Wetmelon/Salus/Hardware/Salus.pdf

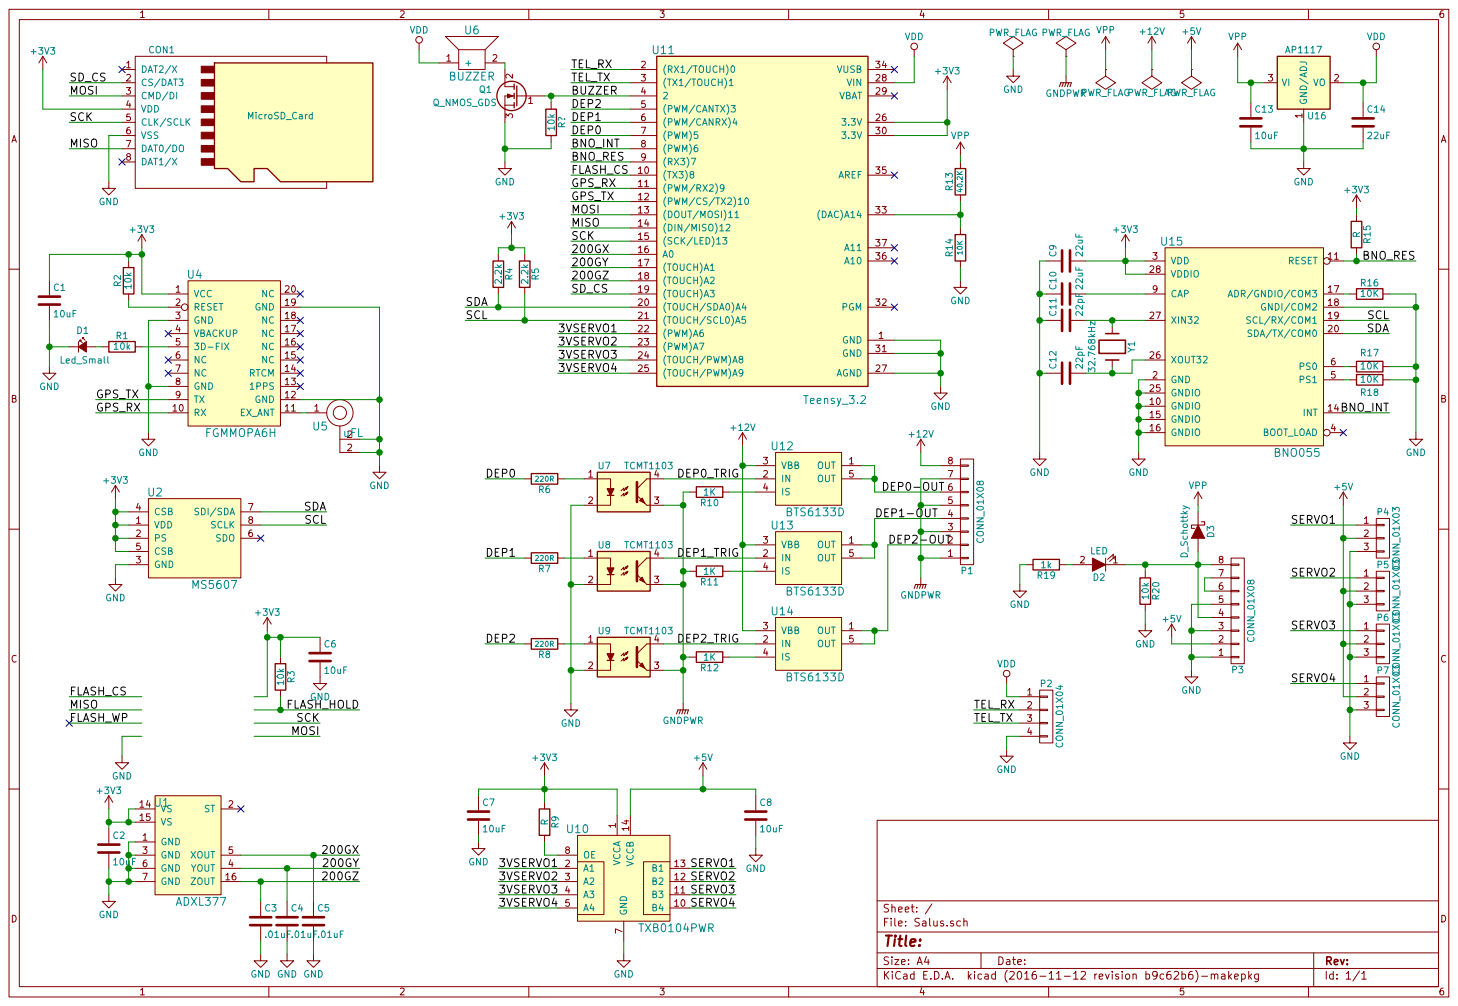
[picture p1: page 1]

Id: 1/1 Title: File: Salus.sch Sheet: /
