Wetmelon/Salus/Hardware/Salus_Board.pdf

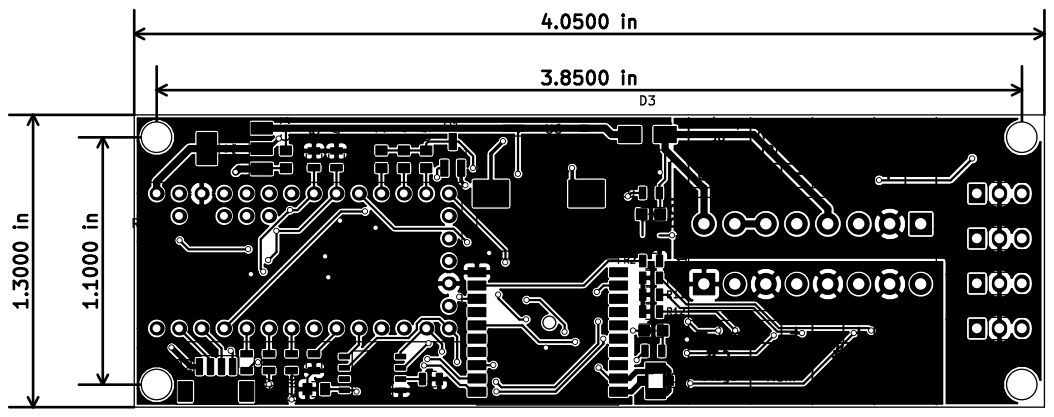
[picture p2: page 1]
