Wetmelon/Salus/Hardware/Salus.kicad_pcb

## KiCad design Hardware/Salus.kicad_pcb (2017-03-23)

Schematic: Salus.sch

Parts:
C1, C2, C6, C7, C8, C13: 10uF; C_0805
C3, C4, C5: .01uF; C_0805
C9, C10, C14: 22uF; C_0805
C11, C12: 22pF; C_0805
CON1: MicroSD_Card; MicroSD_TF001B
D1: Led_Small; LED-0805
D2: LED; LED-0805
D3: D_Schottky; SMA_Standard
P1, P3: CONN_01X08; TerminalBlock_Pheonix_PT-3.5mm_8pol
P2: CONN_01X04; DF13-4
P4, P5, P6, P7: CONN_01X03; Pin_Header_Straight_1x03
Q1: Q_NMOS_GDS; SOT-23_Handsoldering
R1, R2, R3, R20: 10k; R_0805
R4, R5: 2.2k; R_0805
R6, R7, R8: 220R; R_0805
R9, R15: R; R_0805
R10, R11, R12: 1K; R_0805
R13: 40.2K; R_0805
R14, R16, R17, R18: 10K; R_0805
R19: 1k; R_0805
U1: ADXL377; QFP_16
U2: MS5607
U3: S25FL127SAMBFI101; SOIC-8-N
U4: FGMMOPA6H; FGPMMOPA6H
U5: uFL; U.FL-CON
U6: BUZZER; CT-1205C-SMT
U7, U8, U9: TCMT1103; SOIC-4
U10: TXB0104PWR; TSSOP-14
U11: Teensy_3.2; Teensy_3.2+4
U12, U13, U14: BTS6133D; TO-252-5
U15: BNO055; LGA28_5832
U16: AP1117; SOT-223
Y1: 32.768kHz; SOJ-4

Connections:
+3V3: C1.1, C2.1, C6.1, C7.1, C9.2, CON1.4 (VDD), R2.2, R3.1, R4.1, R5.1, R9.1, R15.1, U1.14 (VS), U1.15 (VS), U2.1 (VDD), U2.2 (PS), U2.4 (CSB), U2.5 (CSB), U3.5, U4.1 (VCC), U10.1 (VCCA), U11.26 (3.3V), U11.30 (3.3V), U15.3 (VDD), U15.28 (VDDIO)
+5V: C8.1, P3.2, P4.2, P5.2, P6.2, P7.2, U10.14 (VCCB)
+12V: P1.8, U12.3 (VBB), U13.3 (VBB), U14.3 (VBB)
/3VSERVO1: U10.2 (A1), U11.22 ((PWM)A6)
/3VSERVO2: U10.3 (A2), U11.23 ((PWM)A7)
/3VSERVO3: U10.4 (A3), U11.24 ((TOUCH/PWM)A8)
/3VSERVO4: U10.5 (A4), U11.25 ((TOUCH/PWM)A9)
/200GX: C5.1, U1.5 (XOUT), U11.16 (A0)
/200GY: C4.1, U1.4 (YOUT), U11.17 ((TOUCH)A1)
/200GZ: C3.1, U1.16 (ZOUT), U11.18 ((TOUCH)A2)
/BNO_INT: U11.8 ((PWM)6), U15.14 (INT)
/BNO_RES: R15.2, U11.9 ((RX3)7), U15.11 (RESET)
/BUZZER: Q1.1 (G), U11.4 (2)
/DEP0: R6.2, U11.7 ((PWM)5)
/DEP0-OUT: P1.6, U12.1 (OUT), U12.5 (OUT)
/DEP0_TRIG: U7.4, U12.2 (IN)
/DEP1: R7.2, U11.6 ((PWM/CANRX)4)
/DEP1-OUT: P1.4, U13.1 (OUT), U13.5 (OUT)
/DEP1_TRIG: U8.4, U13.2 (IN)
/DEP2: R8.2, U11.5 ((PWM/CANTX)3)
/DEP2-OUT: P1.2, U14.1 (OUT), U14.5 (OUT)
/DEP2_TRIG: U9.4, U14.2 (IN)
/FLASH_CS: U3.1, U11.10 ((TX3)8)
/FLASH_HOLD: R3.2, U3.6
/FLASH_WP: U3.3
/GPS_RX: U4.10 (RX), U11.11 ((PWM/RX2)9)
/GPS_TX: U4.9 (TX), U11.12 ((PWM/CS/TX2)10)
/MISO: CON1.7 (DAT0/DO), U3.2, U11.14 ((DIN/MISO)12)
/MOSI: CON1.3 (CMD/DI), U3.8, U11.13 ((DOUT/MOSI)11)
/SCK: CON1.5 (CLK/SCLK), U3.7, U11.15 ((SCK/LED)13)
/SCL: R5.2, U2.8 (SCLK), U11.21 ((TOUCH/SCL0)A5), U15.19 (SCL/RX/COM1)
/SDA: R4.2, U2.7 (SDI/SDA), U11.20 ((TOUCH/SDA0)A4), U15.20 (SDA/TX/COM0)
/SD_CS: CON1.2 (CS/DAT3), U11.19 ((TOUCH)A3)
/SERVO1: P4.1, U10.13 (B1)
/SERVO2: P5.1, U10.12 (B2)
/SERVO3: P6.1, U10.11 (B3)
/SERVO4: P7.1, U10.10 (B4)
/TEL_RX: P2.2, U11.2 ((RX1/TOUCH)0)
/TEL_TX: P2.3, U11.3 ((TX1/TOUCH)1)
GND: C1.2, C2.2, C3.2, C4.2, C5.2, C6.2, C7.2, C8.2, C9.1, C10.1, C11.1, C12.1, C13.2, C14.2, CON1.6 (VSS), D1.1 (K), P2.4, P3.1, P3.3, P3.5, P4.3, P5.3, P6.3, P7.3, Q1.3 (S), R14.1, R16.2, R17.2, R18.2, R19.2, R20.2, U1.1 (GND), U1.3 (GND), U1.6 (GND), U1.7 (GND), U2.3 (GND), U3.4, U4.3 (GND), U4.8 (GND), U4.12 (GND), U4.19 (GND), U5.2, U7.2, U8.2, U9.2, U10.7 (GND), U11.1 (GND), U11.27 (AGND), U11.31 (GND), U15.2 (GND), U15.10 (GNDIO), U15.15 (GNDIO), U15.16 (GNDIO), U15.18 (GNDI/COM2), U15.25 (GNDIO), U16.1 (GND/ADJ)
GNDPWR: P1.1, P1.3, P1.5, P1.7, R10.2, R11.2, R12.2, U7.3, U8.3, U9.3
unnamed: C10.2, U15.9 (CAP)
unnamed: C11.2, U15.27 (XIN32), Y1.1
unnamed: C12.2, U15.26 (XOUT32), Y1.4 (2)
unnamed: D1.2 (A), R1.1
unnamed: D2.1 (K), D3.2 (A), P3.4, P3.8, R20.1
unnamed: D2.2 (A), R19.1
unnamed: P3.6, P3.7
unnamed: Q1.2 (D), U6.2
unnamed: R1.2, U4.5 (3D-FIX)
unnamed: R2.1, U4.2 (RESET)
unnamed: R6.1, U7.1
unnamed: R7.1, U8.1
unnamed: R8.1, U9.1
unnamed: R9.2, U10.8 (OE)
unnamed: R10.1, U12.4 (IS)
unnamed: R11.1, U13.4 (IS)
unnamed: R12.1, U14.4 (IS)
unnamed: R13.1, R14.2, U11.33 ((DAC)A14)
unnamed: R16.1, U15.17 (ADR/GNDIO/COM3)
unnamed: R17.1, U15.6 (PS0)
unnamed: R18.1, U15.5 (PS1)
unnamed: U4.11 (EX_ANT), U5.1
VDD: C14.1, P2.1, U6.1 (+), U11.28 (VIN), U16.2 (VO)
VPP: C13.1, D3.1 (K), R13.2, U16.3 (VI)

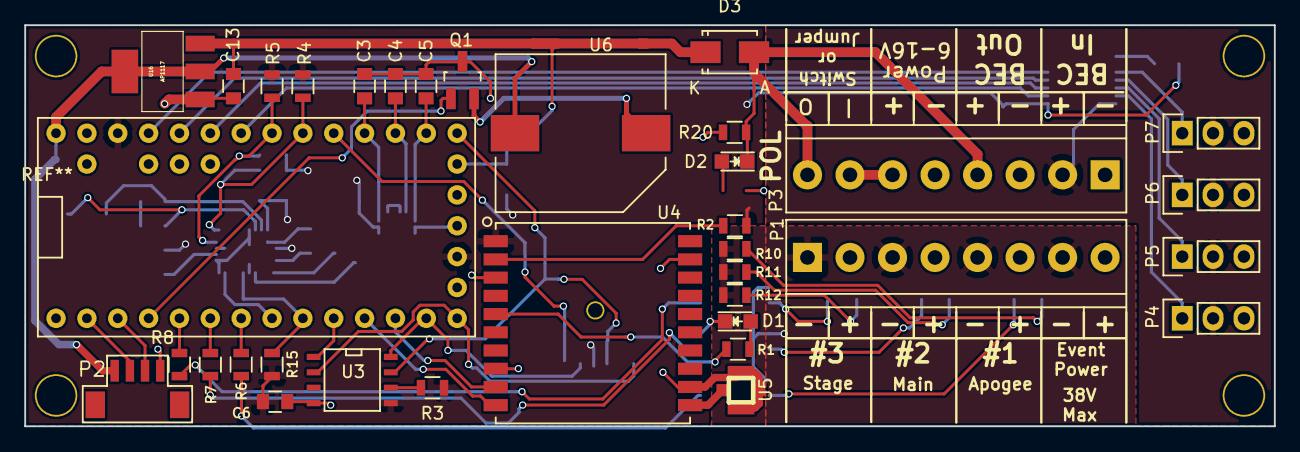
[picture p3: board Salus.kicad_pcb from above]

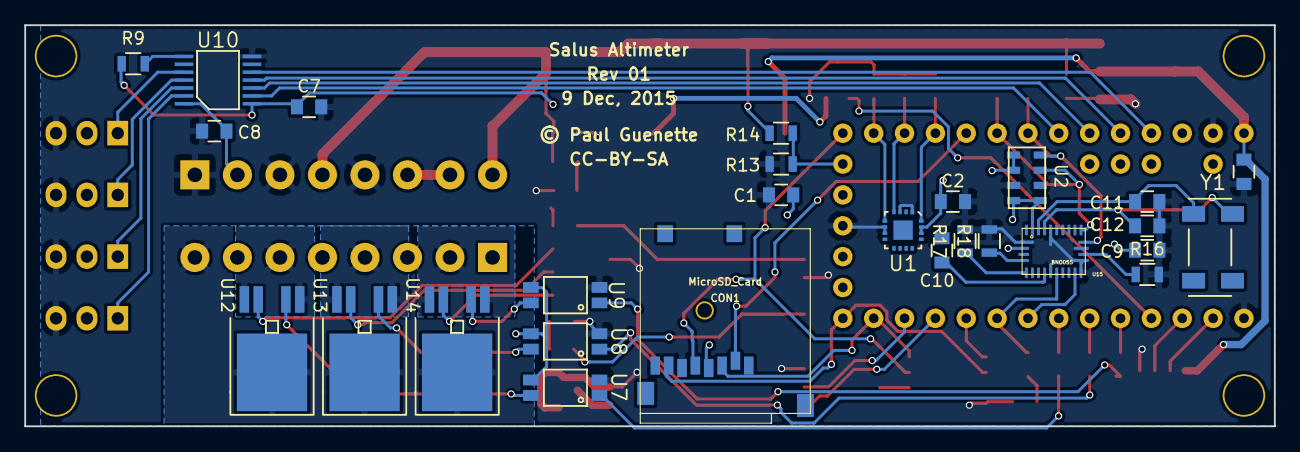
[picture p4: board Salus.kicad_pcb from below]

Board: 2 copper layers, 102.9 x 33.0 mm, 62 parts (27 on the bottom side), 63 nets.
