Wetmelon/Salus/(commit log)

2016-09-06 Add Accel and Gyro events for BNO055
2016-09-08 Return Baro to 200hz
2016-09-08 Remove Analog pin modes
2016-09-19 Tweaks to program flow
2016-11-06 Fix trigger orientation, short beeps during flight
    [Salus.ino, Salus_Common.h, Salus_Inertial.h]
2016-11-06 Fix logging file size (60 minutes)
    [Salus_Common.h, Salus_Logging.cpp]
2016-11-06 Reset "ground" altitude at liftoff
    [Salus.ino]
2016-11-14 Add Hardware to repo
    [Salus.kicad_pcb, Salus.sch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]
2016-11-14 Move Wetmelon lib into folder, point schematic at it.
2017-03-23 Minor debug change
    [Salus.kicad_pcb]
2017-03-25 Replace the unpacking script with the correct one
    [SalusPython.py]
2017-11-16 Change sensor ID to force re-calibration
2017-11-16 Revert "Speed up GPS communication to 115200 baud"
    This reverts commit 62add5c53efce33f091733036830cb9ddf044977.
    [Salus.ino, Salus_GPS.cpp]
