Wetmelon/Salus/(notices)

Notices in the files:
Hardware/Salus.kicad_pcb:
CC-BY-SA
© Paul Guenette
